OneKiwiTech/ontech-kicad-library/(commit log)

2022-07-15 add STM32WB55Rx
2022-07-16 update stm32wb5
2022-07-16 update footprint
2022-07-24 add symbol stm32wb35xx
2022-07-24 add footprint UFQFPN48_7.0x7.0_P0.5_EP5.6x5.6
2022-07-24 reset footprint R, L, C
2022-07-24 add footprint Conn_JLink_SWD_20
2022-07-25 add footprint QFN8_3.0X3.0_P0.65_EP1.6X2.4
2022-07-27 add footprint TSOT23-8
2022-07-28 update keywords resistor
2022-07-28 fix footprint name
2022-07-28 fix footprint name2
2022-07-28 add footprint GT-USB-8016A
2022-07-30 add footprint ANT_NFC_10.0x15.2
2022-07-30 add footprint BatteryHolder_P14.0
2022-07-30 add footprint HDR SMD
2022-07-30 add footprint LED_RGB_1.6x1.6
2022-07-30 add footprint QFN10_2.0x2.0_P0.5
2022-07-30 add footprint USB_C_Receptacle_Yuandi_TYPE-611S-T3
2022-07-31 add 3d for footprint QFN10_2.0x2.0_P0.5
2022-07-31 add footprint nfc
2022-09-28 add stm32h747
2022-10-01 update power
2022-10-02 update symbol power
2022-10-05 add LGA14_3.0x2.5_P0.5_X3Y4.kicad_mod
2022-10-05 add LGA16_3.0x3.0_P0.5_X3Y5.kicad_mod
2022-10-05 add TFBGA265_14.0x14.0_P0.8.kicad_mod
2022-10-05 add WQFN20_4.0x4.0_P0.5_EP2.7x2.7.kicad_mod
2022-10-05 add TSOP-5.kicad_mod
2022-10-06 add CT10-1530-G1.kicad_mod
2022-10-06 add DirectFET_L8.kicad_mod
2022-10-06 add L_6.0x6.0_H4.5.kicad_mod
2022-10-06 add L_8.0x8.5_H5.0.kicad_mod
2022-10-06 add MY-1220-03.kicad_mod
2022-10-06 add UTR-1440K-TT-R_D14.4.kicad_mod
2022-10-06 add WA8351-AL.kicad_mod
2022-10-06 add WS2812B-Mini_3.5x3.5.kicad_mod
2022-10-13 add stm32wb55
2022-10-17 add MountingHole_3.3_M3_Oval
2022-10-20 add power PV3_FM
2022-11-07 add footprint TSSOP28_4.4x9.7_P0.65_EP2.9x5.7
2022-11-07 add bom v3
2022-11-07 update bom v3
2022-11-15 add one-kiwi.kicad_wks
2022-11-15 add skua.kicad_wks
2022-11-16 fix get footprint
2022-11-16 update footprint symbol
2022-11-16 add QFN34_4.0x5.0_X4Y10.kicad_mod
2022-11-16 add SSOP10_3.9x4.9_P1.0.kicad_mod
2022-11-23 add Potentiometer_Bourns_3386C_Horizontal.kicad_mod
2022-11-23 add QFN22_3.0x5.0_P0.5_X2Y9_EP.kicad_mod
2022-11-23 add TO-252-3_GDS.kicad_mod
2022-11-23 add TO-277B_AC.kicad_mod
2022-11-28 add TP_S6.0mm.kicad_mod
2022-11-28 add TP_S10.0mm.kicad_mod
2022-11-29 add QFN10_1.4x1.8_P0.4_X3Y2.kicad_mod
2022-12-04 add Cap_Radial_D16.0_P7.5_H26.0.kicad_mod
2022-12-08 add TP_S3.0_D1.5.kicad_mod
2022-12-08 add TP_S6.0_D3.0.kicad_mod
2022-12-08 add TP_S6.0_D3.0_C1.0.kicad_mod
2022-12-08 add TP_S10.0_D4.0.kicad_mod
2022-12-19 add SiP-LGA86_7.3x11.0.kicad_mod
2023-01-15 update footprint QFN10_2.0x2.0_P0.5.kicad_mod
2023-01-15 update footprint QFN8_3.0X3.0_P0.65_EP1.6X2.4.kicad_mod
2023-01-15 update footprint SiP-LGA86_7.3x11.0.kicad_mod
2023-01-15 add Button_Switch_SMD.3dshapes
2023-01-15 add SW_SPST_SKSCLDE010.kicad_mod
2023-01-15 add USB_C_Receptacle_Amphenol_12402082E512A.kicad_mod
2023-03-30 add solder_paste_margin
2023-04-01 add footprint
2023-04-24 add /QFN26_3.5x3.5_P0.45.kicad_mod
2023-04-27 add QFN26_3.5x3.5_P0.45.kicad_mod
2023-05-03 update footprint HDR_P2.54
2023-06-24 add QFN28_5.0x5.0_P0.5_EP3.1x3.1.kicad_mod
2023-07-10 add power
2023-08-26 add footprint.pretty/ANT_ZOR.kicad_mod
2023-10-20 add symbol_power_gnd.kicad_sym
2023-11-28 add C0504_3P.kicad_mod
2023-11-30 add VFQFPN24_4.0X4.0_P0.5_EP2.5x2.5.kicad_mod
2023-12-11 add WS2812B-2020.kicad_mod
2024-01-04 add PG-HDSOP-16.kicad_mod
2024-03-17 add database
    [Cap0201.csv, Cap0402.csv, Cap0603.csv, Cap0805.csv, Cap1206.csv, Cap1210.csv, Res0201.csv, Res0402.csv]
2024-03-27 add VQFN32_5.0x5.0_P0.5_EP3.6x3.6
    [Cap0201.csv, Cap0402.csv, Cap0603.csv, Cap0805.csv, Cap1206.csv, Cap1210.csv, Res0201.csv, Res0402.csv]
2024-06-10 update STM32MP2
2024-06-10 update pin diode
2024-07-24 add LFPAK56D_SGD.kicad_mod
2024-10-10 edit symbol power
2024-11-15 add Connector_Audio.3dshapes
2024-12-10 edit MountingHole
2024-12-17 update Heatsink_AlphaNova_QTUM45
